wojczy/UV-Reflectometer/Design.pdf

# UV-Reflectometer by Klaus Wojczykowski

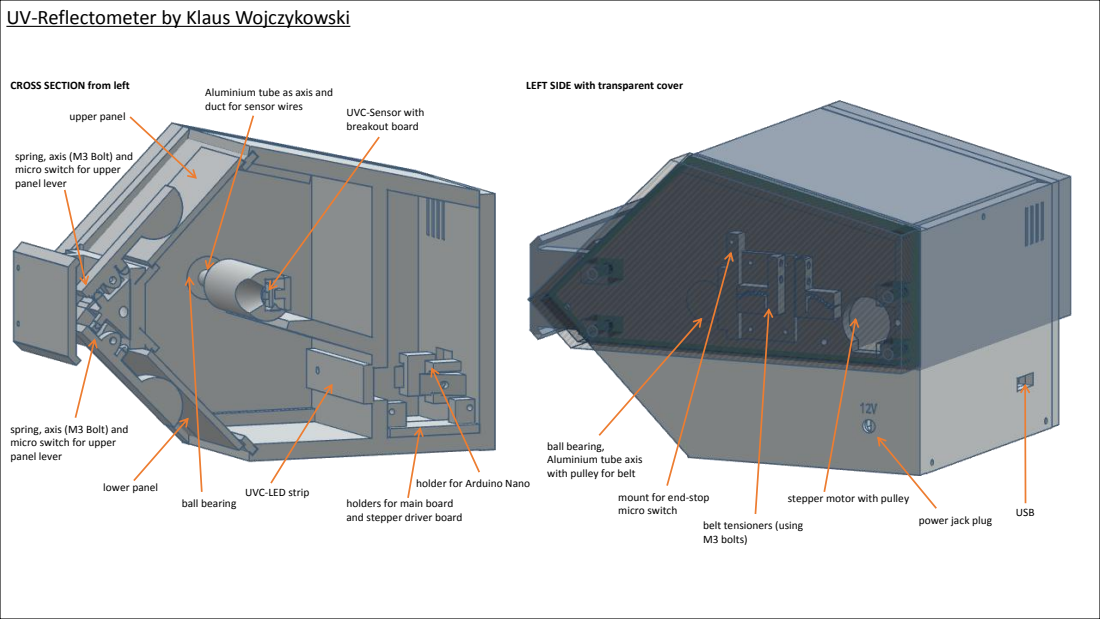
[picture p7: page 1]
upper panel; lower panel; ball bearing; USB

CROSS SECTION from left

LEFT SIDE with transparent cover

Aluminium tube as axis and
duct for sensor wires

UVC-Sensor with
breakout board

spring, axis (M3 Bolt) and
micro switch for upper
panel lever

ball bearing, Aluminium tube axis
with pulley for belt

holder for Arduino Nano

UVC-LED strip

stepper motor with pulley holders for main board
and stepper driver board

mount for end-stop
micro switch

belt tensioners (using
M3 bolts)

power jack plug
