wojczy/UV-Reflectometer/Circuit.pdf

# UV-Reflectometer by Klaus Wojczykowski

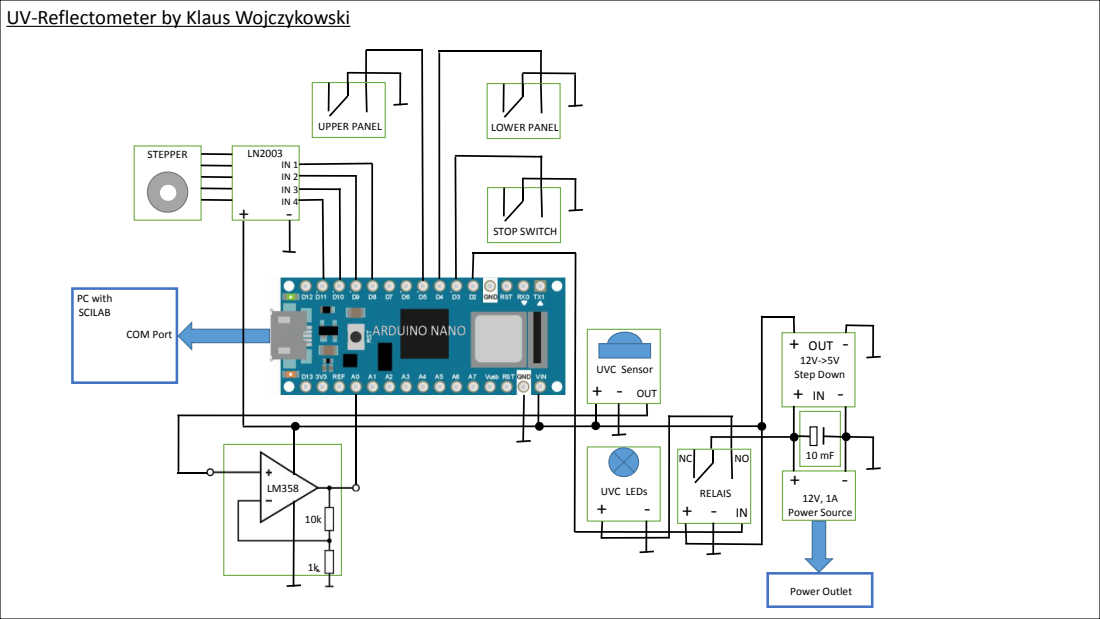
[picture p8: page 1]
RELAIS + - IN; - UVC LEDs; + - OUT; UVC Sensor; STEPPER; 12V, 1A Power Source; 12V->5V Step Down; + OUT - + IN -; STOP SWITCH; UPPER PANEL; LOWER PANEL; Power Outlet; COM Port; PC with SCILAB
